R0SAB/Magpie-RX-FPGA/Структурная_Схема.JPG

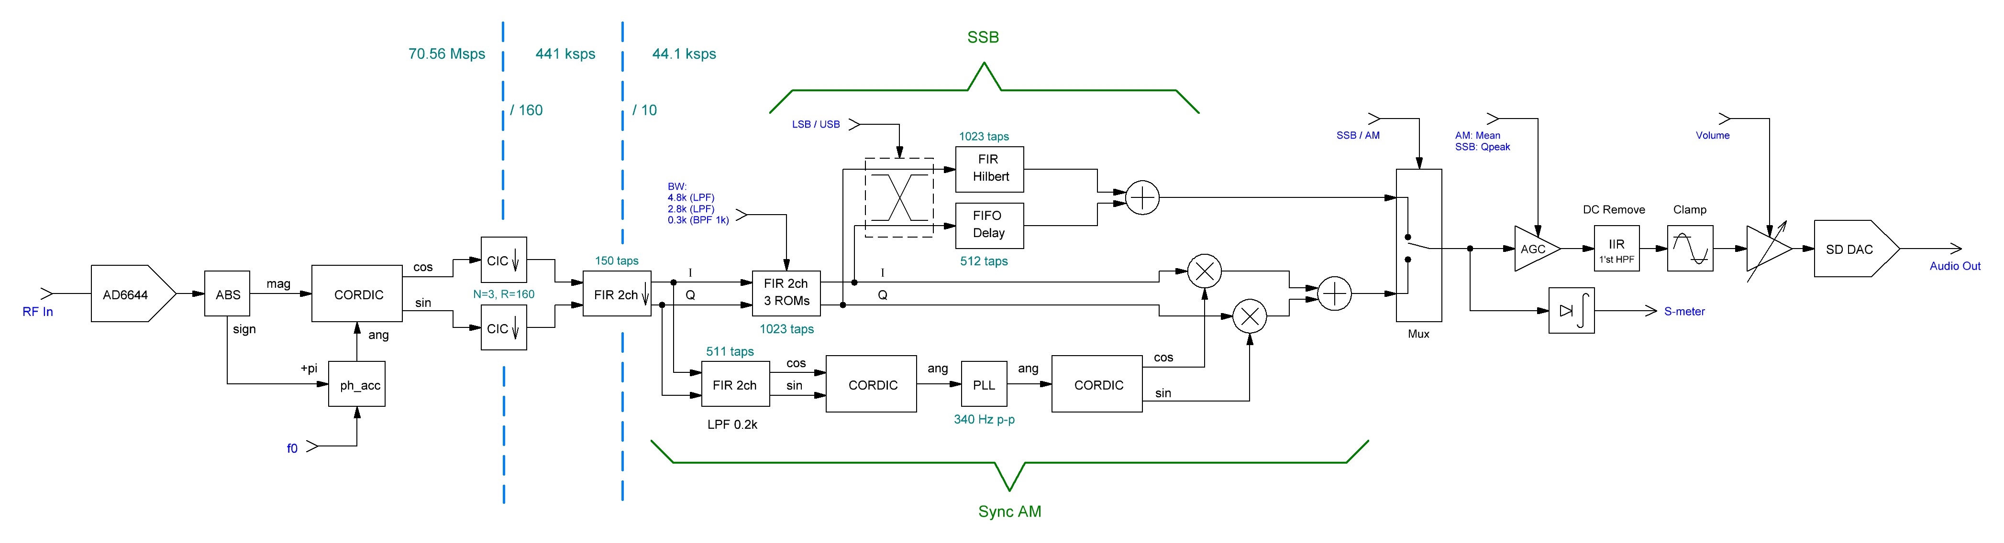
Структурная_Схема.JPG
