R0SAB/Magpie-RX-FPGA/(list of files, drawings)

Other design files:
Дециматор.spl7
Структурная_Схема.spl7
