R0SAB/Magpie-RX-FPGA/src/lo_sync.sv

module lo_sync
(
    input wire signed [23:0]in_I,
    input wire signed [23:0]in_Q,
    input wire clk_44k,
    input wire clk_70M,
    output wire signed [23:0]sync_car_cos,
    output wire signed [23:0]sync_car_sin,
    output reg lock_out,
    output wire iq_rot_dir
);


localparam FREQ_TAU_BITS = 11;
localparam PHASE_INJECT_BITS = 12;

wire signed [23:0]narrow_I;
wire signed [23:0]narrow_Q;
wire signed [23:0]phase_ref;

wire signed [23:0]in_I_round;
wire signed [23:0]in_Q_round;
assign in_I_round = in_I + (1 <<< 5);
assign in_Q_round = in_Q + (1 <<< 5);

fir
#(
	.ORDER(510),
	.IN_MSB(17),
	.OUT_MSB(23),
	.TAPS_MSB(17),
	.GAIN_BITS(6),
	.ROM_FILE("src/fir_coeffs/fir_0k2_lpf_511.txt"),
	.SAMP_SKIP(0)
)
inst_fir_narrow
(
	.clk_H(clk_70M),
	.samp_clk(clk_44k),
	.in_1(in_I_round[23:6]),
	.in_2(in_Q_round[23:6]),
    .out_1(narrow_I),
	.out_2(narrow_Q)
);


cordic_fullser_angmag
#(
    .STAGES(24),                       
    .ANG_MSB(23),                 
    .IN_MSB(23)                   
)
inst_cordic_phase_ref
(
    .sin_in(narrow_I),
    .cos_in(narrow_Q),
    .ang_out(phase_ref),
    .mag_out(),
    .samp_clk(clk_44k),
    .clk_H(clk_70M)
);


reg signed [23:0]ph_acc;
wire signed [16:0]f0;                   // Band (p-p) is 44.1 kHz / (23-16) = 345 Hz
reg signed [1+16+FREQ_TAU_BITS:0]itgr;
assign f0 = itgr[16+FREQ_TAU_BITS:FREQ_TAU_BITS];

wire signed [23:0]phase_diff;
assign phase_diff = phase_ref - ph_acc;
reg signed [23:0]phase_diff_prev;
wire signed [23:0]freq_diff;
assign freq_diff = phase_diff - phase_diff_prev;

wire signed [1+16+FREQ_TAU_BITS:0]itgr_next;
assign itgr_next = itgr + freq_diff + phase_correction;

logic signed [23:0]phase_correction;
logic phase_good;

logic signed [23:0]phase_ref_prev;
logic signed [23:0]phase_ref_diff;
assign phase_ref_diff = phase_ref - phase_ref_prev;
reg signed [33:0]phase_ref_diff_itgr;
wire signed [23:0]phase_ref_diff_itgr_out;
assign phase_ref_diff_itgr_out = phase_ref_diff_itgr >>> 10;


assign iq_rot_dir = phase_ref_diff_itgr[33];


always_comb
begin
    if(phase_diff > -(1 <<< 22) && phase_diff < (1 <<< 22)) phase_good = 1;
    else phase_good = 0;

    if(~phase_good) phase_correction = phase_diff >>> (24-PHASE_INJECT_BITS-3);
    else phase_correction = phase_diff >>> (24-PHASE_INJECT_BITS);
end

always @ (posedge clk_44k)
begin

    ph_acc <= ph_acc + f0;

    if(itgr_next > ((1 <<< (16+FREQ_TAU_BITS))-1)) itgr <= ((1 <<< (16+FREQ_TAU_BITS))-1);
    else
    if(itgr_next < -(1 <<< (16+FREQ_TAU_BITS))) itgr <= -(1 <<< (16+FREQ_TAU_BITS));
    else
    itgr <= itgr_next;

    phase_diff_prev <= phase_diff;

    phase_ref_prev <= phase_ref;
    phase_ref_diff_itgr <= phase_ref_diff_itgr + phase_ref_diff - phase_ref_diff_itgr_out;

end


wire unsigned [23:0]phase_cordic;
assign phase_cordic = {~ph_acc[23], ph_acc[22:0]};


cordic_fullser_sincos                           
#(
    .STAGES(24),                                  
    .PHASE_MSB(23),                               
    .OUT_MSB(23)                                  
)
inst_cordic_sync
(
    .phase_in(phase_cordic),                   
    .start_length(24'd4934475),     // 2^23 / 1.7            
    .samp_clk(clk_44k),
    .clk_H(clk_70M),
    .sin_out(sync_car_sin),
    .cos_out(sync_car_cos)
);


localparam LOCK_TAU_BITS = 15;

logic [7:0]lock_probability;
logic [7+LOCK_TAU_BITS:0]probability_itgr;
assign lock_probability = probability_itgr >>> LOCK_TAU_BITS;

always @ (posedge clk_44k)
begin
    probability_itgr <= probability_itgr + (phase_good ? 255 : '0) - lock_probability;
end


logic [15:0]lock_mm;
localparam LOCK_MM_END = 2000;

always @ (posedge clk_44k)
begin
    if(/*~phase_good*/lock_probability > 160) lock_mm <= 0;
    else
    if(lock_mm < LOCK_MM_END) lock_mm <= lock_mm + 1;

    if(lock_mm == LOCK_MM_END) lock_out <= 0;
    else lock_out <= 1;
end




endmodule
