R0SAB/Magpie-RX-FPGA/src/gowin_pll/mcu_ss_pll_tmp.v

//Copyright (C)2014-2024 Gowin Semiconductor Corporation.
//All rights reserved.
//File Title: Template file for instantiation
//Tool Version: V1.9.11 (64-bit)
//Part Number: GW5A-LV25MG121NC1/I0
//Device: GW5A-25
//Device Version: B
//Created Time: Sat Sep 12 16:57:00 2026

//Change the instance name and port connections to the signal names
//--------Copy here to design--------

    mcu_ss_pll your_instance_name(
        .clkout0(clkout0), //output clkout0
        .clkin(clkin) //input clkin
    );

//--------Copy end-------------------
