R0SAB/Magpie-RX-FPGA/src/gowin_osc/gowin_osc_tmp.v

//Copyright (C)2014-2025 Gowin Semiconductor Corporation.
//All rights reserved.
//File Title: Template file for instantiation
//Tool Version: V1.9.12.01 (64-bit)
//IP Version: 1.0
//Part Number: GW2A-LV18PG256C8/I7
//Device: GW2A-18
//Device Version: C
//Created Time: Fri Aug  7 09:48:07 2026

//Change the instance name and port connections to the signal names
//--------Copy here to design--------

    gowin_osc your_instance_name(
        .oscout(oscout) //output oscout
    );

//--------Copy end-------------------
