R0SAB/Magpie-RX-FPGA/(commit log)

2026-06-18 Начало проекта
2026-06-18 Добавлен gitignore, созданр файл физических констрейнов
2026-06-18 Добавлена распиновка SPI
2026-06-18 Написан приёмник частоты по SPI
2026-06-18 Добавлена фапча 64.8 МГц и тестовый фазовый аккумулятор с управлением по SPI
2026-06-18 Приём кода частоты из МК работает (а вот передача кода s-метра пока хз)
2026-06-18 SPI работает (4 байта от МК, 1 байт обратно)
2026-06-18 Увеличен период тестового деителя s-метра
2026-06-25 Добавлен приём модуляции и полосы из МК и вывод его на светодиоды
2026-06-28 Подключен АЦП, клок 65 МГц взят с него
2026-07-03 clk_65M переименован в clk_70M (новая частота 70.56 МГц с SI5331)
2026-07-03 Добавлен приём громкости по SPI (регистр volume). Название регистра mode_ctrl изменено на modes
2026-07-19 Тёмная тема?
2026-07-20 Добавлены коэффициенты КИХов и поясняющая схема в SPlan
    [Дециматор.spl7]
2026-07-20 Написан входной гетеродин на кордике (и тестовый сигма-дельта ЦАП на его выходе). Собирается, надо тестить в железе
2026-07-20 Добавлен комментарий про основной клок 70.56 МГц
2026-07-21 Гетеродин работает, проверено в железе
2026-07-21 Добавлены КИХ и CIC
2026-07-21 CIC работает
2026-07-21 Первый КИХ даунсемплера вроде работает
2026-07-22 Кихи даунсемплера работают. Добавлена задержка подачи клока 70 МГц - фильтры ломаются от мусора с SI5351 при включении питания. Также, надо проверить разрядности перемножителей и аккумуляторов кихов 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
2026-07-22 Разрядности коэффициентов кихов увеличены до 24 бит, что-то с усилением (великовато), чувствительность 10 мкВ есть
    [Дециматор.spl7]
2026-07-23 Переделан вход кордика гетеродина: вход и выход 16 бит, модуль сигнала с АЦП в старших разрядах, младшие два дописаны нулями (как в USB SDR). Теперь уверенные 10 мкВ есть
2026-07-23 Первый ких возвращён на 18 бит у входа и коэффициентов, для экономии перемножителей. Расчётный ДД 114 дБ
    [Дециматор.spl7]
2026-07-25 Изменена распиновка АЦП для нового макета
2026-07-25 Успешный перенос на новый макет; изменена распиновка АЦП
2026-07-27 Тестовая демлодуляция АМ
2026-07-28 Второй ких даунсемплера возвращён на 18 бит
2026-07-28 Кордик АМ вроде как заработал при 24 битах
2026-07-28 Дециматор с одним кихом вместо двух, CIC сделан злее, у киха выход 24 бита
2026-07-28 Все фильтры 18-битные, экономично, даже с подчисточным фильтром, но для постоянной составляющей АМ разрядности мало (хоть и работает исправно)
    [downsampler.v, top.sv]
2026-08-04 Успешный перенос на новую плату, девайс заменён на GW2A-18C
2026-08-04 Добавлена регулировка громкости
2026-08-07 Новая плата: изиенена распиновка
2026-08-07 Добавлен генератор клока для МК с расширением спектра
2026-08-07 Спектр сделан ещё шире
2026-08-07 Ширина спектра возвращена обратно
2026-08-07 Клок SS заменён с OSC на rPLL на 199.8 МГц
2026-08-07 Переезд на 24 бита
2026-08-08 АРУ минимально работает
2026-08-08 КИХ даунсемплера уменьшен до 18 бит
2026-08-08 АРУ настроена удачнее (разобраться с разрядностями)
2026-08-12 Сканирование ss переведено на тактирование от выходного клока
2026-08-13 Добавлена регулировка полосы пропускания; более удачная(?) настройка SS
2026-08-13 К подчисточному фильтру добавлена полоса 3 кГц
2026-08-13 Добавлен подавитель постоянки, ЦАП ощутимо шипит
2026-08-13 Добавлен приём однополосной модуляции
2026-08-14 Максимальное усиление АРУ ограничено запасом в 1 бит
2026-08-14 В АРУ добавлен квазипиковый детектор для (однополосного сигнала), и выбор режима детектора (квазипик для однополосного, среднее для АМ)
2026-08-14 Свой сигма-дельта ЦАП
2026-08-14 SS переделан на LFSR, теперь в однополосном режиме не слышно тонов около 8 МГц
2026-08-14 S-метр работает (пока без ограничения на +36 дБ)
2026-08-14 Ограничение добавлено (пока без нормальной параметризации)
2026-08-15 S-метр вынесен в отдельный модуль, добавлены подавители постоянки по I/Q
2026-08-15 Немного переделана калибровка S-метра
2026-08-15 Убрано вырезание постоянки из I/Q (а как какать при нулевой расстройке); добавлен target АРУ для АМ- на 3 дБ выше чем для SSB; подобрано смещение I/Q на входе кордика
2026-08-17 Добавлен модуль, подмешивающий в код S-метра сигнал перегрузки АЦП OVR (значение 16)
2026-08-17 Условие OVR сделано жёстче - хотя бы один семпл, а не два
2026-08-17 "heterodyne" переименован в "lo_mixer"
2026-08-17 Правка комментов
2026-08-18 Черновик гетеродина для синхронного приёма АМ (пока не работает)
2026-08-19 Первый работающий вариант синхронного гетеродина
2026-08-19 Кордик переделан на вычисление угла с избыточной разрядностью
2026-08-19 Сделан отдельный узкополосный (200 Гц) тракт для синхронного гетеродина, работоспособен до достаточно низкого с/ш. КИХ с регулируемой полосой вынесен наружу. Попробовать расширить выход даунсемплера 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
2026-08-20 Синхронный демодулятор заработал (на обе боковые полосы, просто I и Q)
2026-08-20 Выкинут подчисточный фильтр, выкинут самый первый кордик. В интегратор фапчи синхронного гетеродина добавлено насыщение. Добавлена структурная схема в сплане
    [Структурная_Схема.spl7]
2026-08-20 АРУ переведена в квазипиковый режим и для SSB, и для АМ
2026-08-20 Таргет АМ в АРУ сделан в два раза больше
2026-08-20 Исправлено переключение полосы (сигнал bw_in вместо bandwidth был подключен к порту bw_in)
    [top.sv]
2026-08-20 PHASE_INJECT_BITS увеличено до 12 - для становления ошибки фазы ненулевой раньше (из-за усечения)
2026-08-21 Ошибка фазы теперь добавляется прямо в аккумулятор (до этого дважды усекалась)
2026-08-21 Коррекция фазы переделана на слабую +-1
2026-08-22 Синхронный демодулятор АМ полностью исправен. Исправлена таблица арктангенсов кордика (из-за неправильной нормировки фаза крутилась в 4 раза быстрее и коррекция фазы не работала); добавлена коррекция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
    [cordic_fullser_angmag.v, lo_sync.sv, top.sv]
2026-08-22 Коррекция фазы перенесена в ограничитель интегратора
2026-08-22 Исправлено насыщение интегратора
2026-08-24 В файле проекта задан модуль верхнего уровня (top)
2026-08-24 Немного поправлен ЦАП
2026-08-25 В мультиплексоре S-метра добавлена логика разрядки, чтобы он не мерцал слишком быстро на границе уровней
2026-08-27 Добавлены 2 бита к перемножителю АРУ после добавления новых ОУ с более высоким усилением
2026-08-27 Исправлен БОЛЬШОЙ косяк с кордиком входного гетеродина: АЦП был в старших разрядах длины входного вектора, а разрядность кордика была без учёта усиления. Исправлено: сигнало с АЦП на бит вправо (тепе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
    [agc.sv, lo_mixer.sv]
2026-08-27 Поправлена калибровка S-метра
2026-08-28 Добавлен ЦАП на дробном ШИМе
2026-08-29 Эксперимент: перевод даунсемплера полностью на 24 бита
2026-08-30 Калибровка S-метра
2026-09-02 Добавлен bass booster
2026-09-03 Добавлено шумоподавление АМ (опознавание наличия несущей по ненулевой постоянной составляющей на входе АРУ)
2026-09-03 Увеличена постоянная времени детектора несущей в АРУ
2026-09-03 Постоянная времени уменьшена на 2 бита
2026-09-04 Синхронный гетеродин: при разности фаз меньше пи/2 петля фазы сделана на 3 бита сильнее для более быстрого захвата при неудачной исходной фазе
2026-09-04 Добавлен SPDIF передатчик
2026-09-07 Начало оптимизации: все аккумуляторы и медленные перемножители вынесены в логику, кое-где уменьшена разрядность
2026-09-09 Выкинуты лишние файлы, синхронный демодулятор АМ вынесен в отдельный модуль
2026-09-10 ПРОВЕРИТЬ: Добавлен байт статуса, в него вынесен OVR и добавлен sync_lock, логика задержки затухания s-метра унесена в s-метр
2026-09-10 На индикатор захвата добавлен одновибратор
2026-09-11 АРУ переделана: добавлены локалпарамы; опознавание несущей теперь - по сравнению со средним значением амплитуды, а не фиксированным порогом
2026-09-12 Переезда на GW5A-25 (Tang 25k)
2026-09-18 Сигнал индикации захвата теперь формируется в синхронном гетеродине (по тому же условию что и "злая" настройка фапчи)
2026-09-18 Исправлено округление в кихах, добавлено округление на входе lo_sync (был ложный захват за постоянку без антенны)
    [fir.v, fir_3roms.v, lo_sync.sv]
2026-09-19 Исправлена разрядность АРУ
2026-09-19 Модуль АРУ переписан с помощью Chatgpt
2026-09-22 В status добавлен бит направления вращения IQ (для индикации в режиме коррекции частоты)
2026-09-22 Добавлен ФНЧ сигнала направления вращения IQ
2026-09-22 Исправлена знаковость интегратора ошибки частоты индикатора расстройки
    [lo_sync.sv]
2026-09-23 В АРУ добавлена регулируемая атака (в битах), убран квазипиковый детектор
2026-09-23 Таргет АРУ в АМ без несущей возвращён на 2000 (был изменён на 3000 в предыдущем коммите, вместе с таргетом при захвате, который вместо 10000 стал 12000)
2026-09-23 В АРУ добавлен задержанный тракт аудио (петля оставлена без изменений); добавлен таймер 100 мс на отпускание
2026-09-24 Уменьшено усиление перед АЦП (и скорректирован S-метр, соответственно)
2026-09-24 Усиление уменьшено ещё сильнее, поправлены АРУ и S-метр
2026-09-25 S-метр и SPI переписаны с помощью ChatGPT
2026-09-28 Игры с цапом
2026-09-30 Таргет АРУ АМ сделан в полтора раза больше (10к - 15к, 2к - 2.8к)
2026-10-09 Добавлен модуль подавления пука на выходе цапа при включении
2026-10-13 Критерий захвата синхронного гетеродина уменьшен с 5000 до 2000 семплов
2026-10-19 Оценка фазы для индикации захвата синхронного гетеродина и коммутации шумодава сделана вероятностной
2026-10-19 Фазовая ОС в синхронном гетеродине переделана на классическую
2026-10-21 Синхронный гетеродин сделан намного быстрее для борьбы с быстрыми замираниями
2026-10-22 Фазовая ОС сделана нелинейной обратно
2026-10-27 Частота SS возвращена на место (8 МГц вместо 8.8 МГц)
2026-10-27 Постоянная времени АРУ уменьшена на 1 бит
2026-10-28 Вайбкод АРУ: добавлено ограничение скорости нарастания и спада усиления (относительная ошибка при малом усилении - т.е. малом сигнале следом за большим - была большая и снижала усиление слишком быстр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
2026-10-28 Таргеты ару задраны в два раза
2026-10-28 Таргеты ару немного уменьшены (около 3 дБ)
2026-10-29 Вариант настройки АРУ: медленнее спад, длинее таймер удержания (150 мс вместо 100)
2026-10-29 Небольшая настройка АРУ; уменьшена постоянная времени вырезания постоянки (около 16 Гц по минус 6 дБ, до этого было 2 гц)
2026-10-29 Отключен таймер удержания АРУ
2026-10-29 Уменьшены таргеты АРУ
2026-10-30 Добавлен кордик для АМ АРУ; сделаны индивидуальные параметры для AM и SSB; таймер удержания работает только в SSB
2026-10-30 Уменьшены твргеты АРУ
2026-10-30 Возвращена квазипиковость в АМ
2026-10-30 АРУ: снят запррет на повышение усиления во время таймера - вместо него повышение замедлено на 4 бита от нормального (всё это только в SSB). Также, таргет АМ уменьшен
2026-10-31 Попытка сделать шумоподавление в АМ через качество несущей (вероятность попадания фазы в узкое окно преобразуется в уставку АРУ)
2026-10-31 Откат от шумодава по фазе несущей: кал
2026-11-01 Новый вариант АРУ: разделение постоянки и переменки в сигнале ОС. Основное регулирование по выпрямленной переменке, а ослабленная постоянка ограничивает шум в паузах
2026-11-02 Ограничение звука сделано как в писиэме
2026-11-02 Отдельные скорости АРУ для АМ (а ещё АМ сделана быстрой, аж стала компрессором)
2026-11-02 (забыл добавить, см. предыдущее)
2026-11-02 Чуть помедленнее
2026-11-06 Добавлен плавный ограничитель после АРУ
2026-11-10 Вайбкод регулировки громкости - через последовательные сдвиги
2026-11-10 Спад усиления в АМ на один бит быстрее
2026-11-11 Спад возвращён на место, увеличена несущая (на 3 дБ)
2026-11-11 Clamp переделан к старому варианту; в SPDIF вместо него заведён выход мягкого ограничителя
2026-11-13 mcu_ss отключен (стмка переведена на внутреннее тактирование 64 МГц, дисплей пишется только при изменении элементов)
2026-11-13 Подстройка АРУ в АМ (турки с их прикольной низкочастотной бУхающей модуляцией перегружали)
